bristolpie/ProxmoxFanControl/(commit log)

2026-11-08 Initial release: Proxmox fan control daemon, web UI and Arduino firmware
    - fancontrold: temperature curves with hysteresis, rolling averages,
    cross-zone floors, automatic ZFS scrub profile, emergency override
    - Web UI: live dashboard, history graphs, curve editor, manual holds
    - JSON API and Prometheus /metrics
    - Arduino Nano firmware: 3 PWM zones, tach RPM, host watchdog
    - install.sh / flash.sh for setup and flashing from the host
    - CI: lint, simulation smoke test, firmware build + release asset
2026-11-08 install.sh: re-scan serial port after stopping a service
    Stopping the service holding the port also ends its child processes,
    which were still listed from the first scan and caused a false
    "free the serial port first" abort. Re-check the port after each stop
    and skip PIDs that have already exited.
    Also redraw the history chart once the first status arrives so the
    zone names appear in the PWM legend.
2026-11-08 web: keep layout identical across tabs
    - reserve the scrollbar gutter so switching between short and long
    tabs doesn't shift the page sideways
    - same font weight for active/inactive tabs so labels don't move
    - save bar on Curves/Settings is now a card aligned with the content
2026-11-08 web: make the manual override two-step flow obvious
    Moving a zone's slider only staged a value; nothing changed until Hold
    was pressed, which wasn't clear. Now:
    - the button reads "Hold at N%" and is highlighted once a value is staged
    - a hint line says what will happen / what is currently held
    - "Cancel" discards a staged value that hasn't been sent
2026-11-08 Named curves and automatic sensor discovery
    Sensors
    - discover every kernel hwmon temperature (CPU cores, NVMe, motherboard,
    GPU, chipset) with IDs that survive reboots (driver:device:label);
    disks are identified by serial
    - built-in combined sensors: CPU, Disks (max), NVMe (max), and one
    "hottest disk" sensor per ZFS pool (from zpool status -LP)
    - ignore unconnected inputs (0 / 127 °C); a missing sensor now reports
    None instead of a stale average, so zones fall back to sensor_fail_pwm
    Curves
    - curves are a named list, each reading any sensor; idle/scrub points
    are optional (null = same as normal)
    - zones pick a curve; floors pick any sensor (or none)
    - old configs are migrated o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
    [fancontrold.py]
2026-11-08 Remove the idle profile
    Curves already follow temperature, so a separate idle curve added little.
    Profiles are now normal and scrub. Existing configs drop their idle
    points and profile.idle_load_below on load (previous file kept as .bak).
2026-11-09 Zones can be turned off; clearer zone panel labels
    A zone with enabled: false holds its fans at 0% and ignores curves,
    floors and manual holds; emergency cooling still runs it. Toggle it in
    Settings > Zones.
    Zone panels now show values as percentages: Sensor, Curve speed (with
    the hysteresis hold explained), Floor (rule and whether it's active)
    and Output (% and raw PWM).
2026-11-09 README: shopping list and two-wire-per-zone wiring
2026-11-09 README: chain multiple fans per zone onto one input
2026-11-09 install.sh: offer to flash the Arduino when its firmware is out of date
    After the service starts, the installer reads the firmware version the
    daemon got from the Arduino (V command) and compares it with the sketch
    in this checkout. If older, it offers flash.sh --release, falling back
    to --build if the download fails. --yes never flashes; it prints the
    command instead.
2026-11-09 README: safety warning and 12 V wiring caution
2026-11-09 README: wiring diagram
2026-11-09 Wiring: splitter-based setup as actually built
    The Arduino feeds the single end of a 4-pin splitter per zone; a
    power-only SATA fan plug feeds 12 V into a spare leg; fans go on the
    other legs. Explain the shared ground and that tach is usually on one
    leg only. Diagram redrawn to match.
2026-11-09 Wiring: label the splitter's female end and male legs
2026-11-09 Wiring: SATA power into the splitter's female end, Arduino and fans on male legs
    Corrects the previous diagram/steps, which had the Arduino on the female
    end. Jumper wires are female-female. Note that RPM needs pin 3 on both
    the fan's and the Arduino's legs.
2026-11-09 Per-zone "RPM wired" setting; README on splitter tach limits
    A zone shows RPM only when tach: true. Unwired tach pins read 0, which
    looked like stopped fans. The RPM chart toggle is hidden when no zone
    is wired, and the Arduino is only polled for RPM when one is.
    README explains why the splitter wiring usually doesn't carry tach to
    the Arduino and the two ways round it.
    [fancontrold.py]
2026-11-09 Dashboard: leave disabled zones out of the fan history chart
2026-11-09 Wiring: one Arduino GND wire is enough; the SATA lead ties the splitter grounds together
2026-11-09 Wiring: Arduino GND beside D2, straight to the Z1 splitter
2026-11-09 Wiring: numbered markers tie each note to its part of the diagram
2026-11-09 Wiring: mark note 1 on every SATA power plug
2026-11-09 Wiring: mark note 3 on every tach wire
2026-11-09 Wiring: show the jumper plug on the splitter end too
2026-11-09 Wiring: show both halves of each splitter connection, white female / dark male, with a key
2026-11-09 Wiring: equal-size F/M connector halves instead of mixed text labels
2026-11-09 Wiring: name the connectors in the legend (4-pin PWM fan F/M, Dupont jumper plug)
2026-11-09 Wiring: Arduino leg as a small M connector with zoom lines to its pin-out
2026-11-09 Wiring: draw the enlarged pin-out as a detail view (lens circle, panel, faint guide lines)
2026-11-09 Wiring: box each whole splitter, title on the box
2026-11-09 Wiring: jumper and daisy-chain entries in the legend, markers centred on the leads
2026-11-09 Wiring: fit the legend back into two rows
2026-11-09 Wiring: warning triangles on tach, drop daisy-chain fan label, renumber notes
2026-11-09 Wiring: drop the extra-fans label on the front fans
2026-11-09 Wiring: A–E part tags matching the 'What you need' list
2026-11-09 README: make 'How each zone is wired' a heading so the parts list can link to it
2026-11-09 Wiring: part tags as rose hexagons (distinct from F/M), E on every jumper wire
